Kymopsis/radar-desk-buddy/enclosure/top-shell.stl

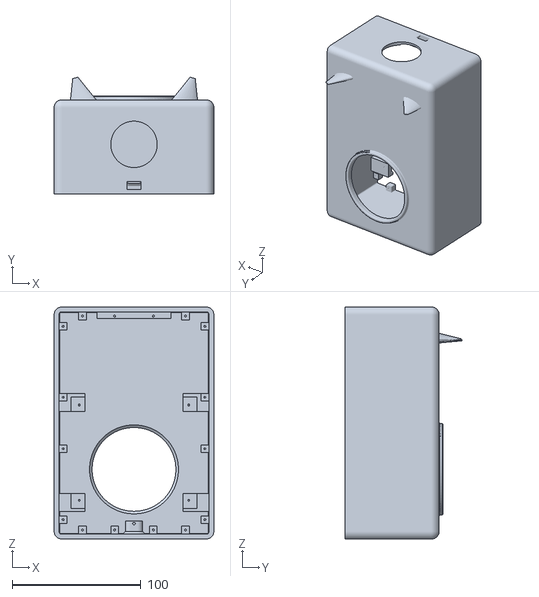
[picture p2: CAD file, 2026-10-29]
enclosure/top-shell.stl
124.0 x 90.6 x 180.0
