Kymopsis/radar-desk-buddy/enclosure/drive-link.stl

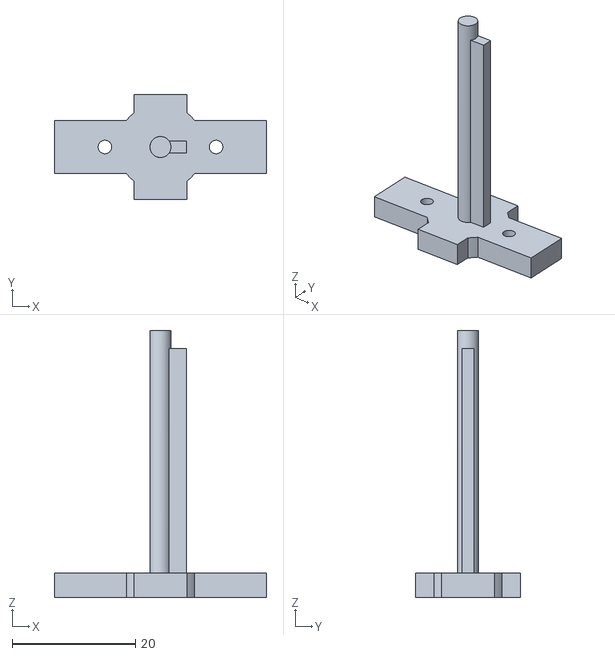
[picture p3: CAD file, 2026-10-29]
enclosure/drive-link.stl
34.4 x 17.0 x 43.2
