Kymopsis/radar-desk-buddy/enclosure/lift-base.stl

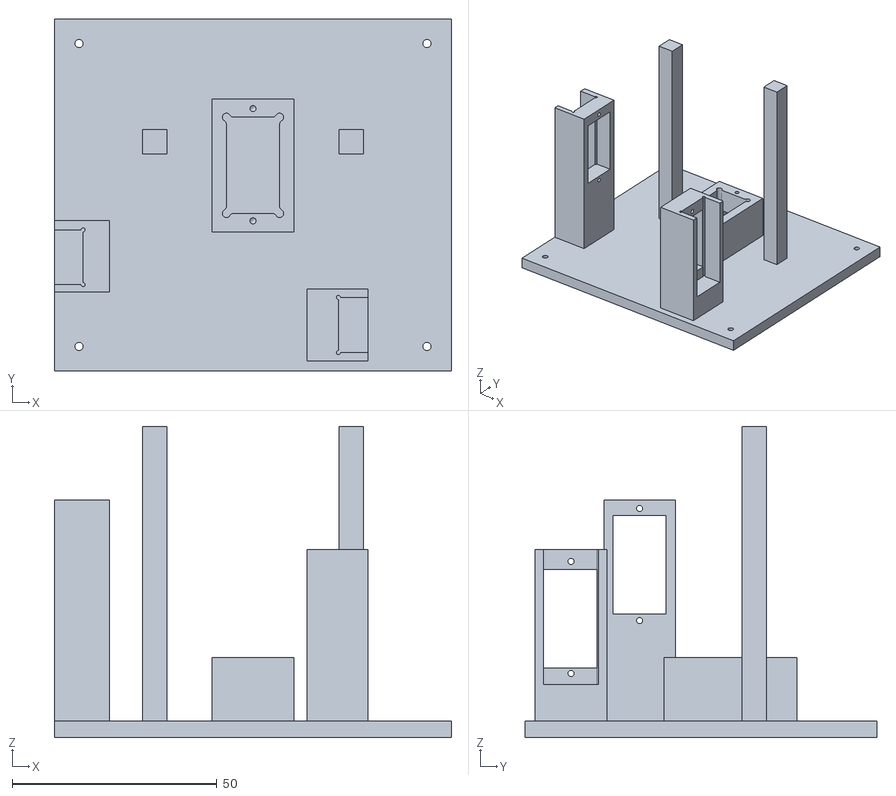
[picture p4: CAD file, 2026-10-29]
enclosure/lift-base.stl
97.0 x 86.0 x 76.0
