Kymopsis/radar-desk-buddy/enclosure/lift-crank.stl

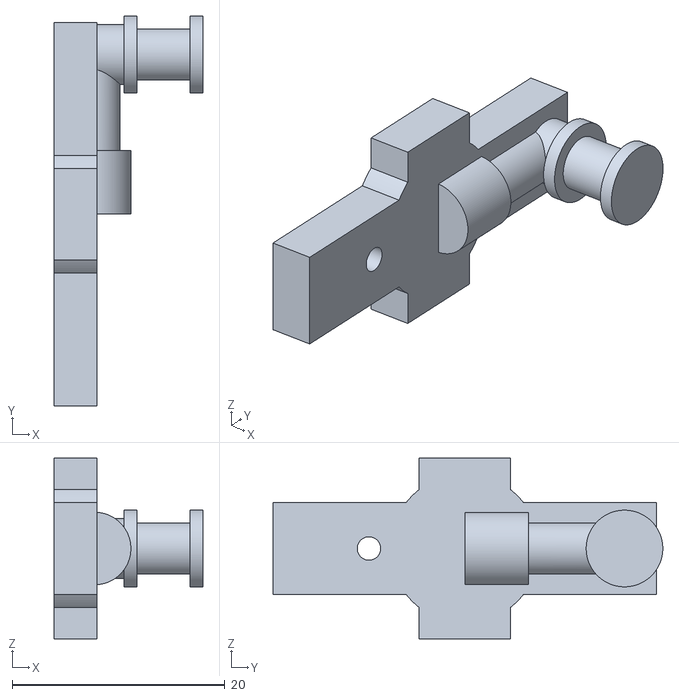
[picture p5: CAD file, 2026-10-29]
enclosure/lift-crank.stl
13.9 x 36.6 x 17.0
