Kymopsis/radar-desk-buddy/enclosure/toy-bracket.stl

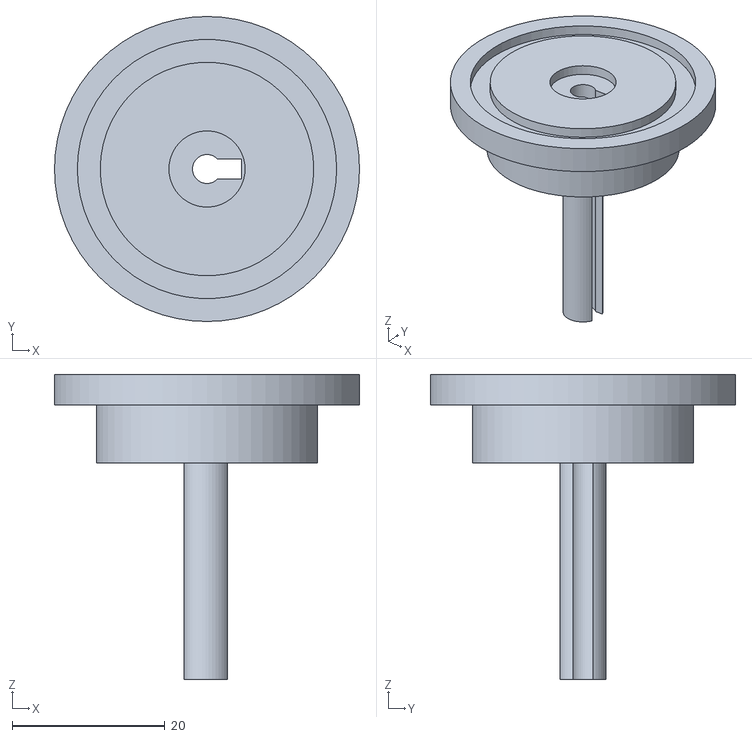
[picture p6: CAD file, 2026-10-29]
enclosure/toy-bracket.stl
40.0 x 40.0 x 40.0
