Kymopsis/radar-desk-buddy/enclosure/lift-link.stl

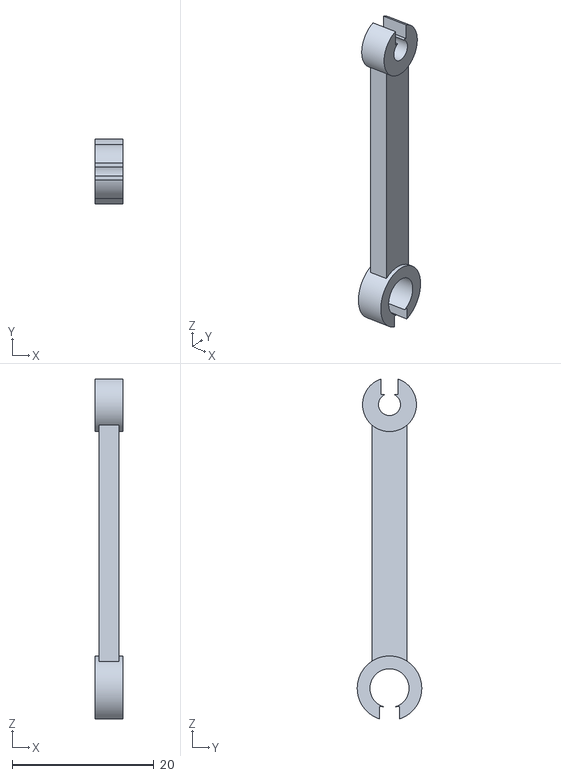
[picture p7: CAD file, 2026-10-29]
enclosure/lift-link.stl
4.00 x 9.10 x 47.9
