Kymopsis/radar-desk-buddy/enclosure/disc-bracket.stl

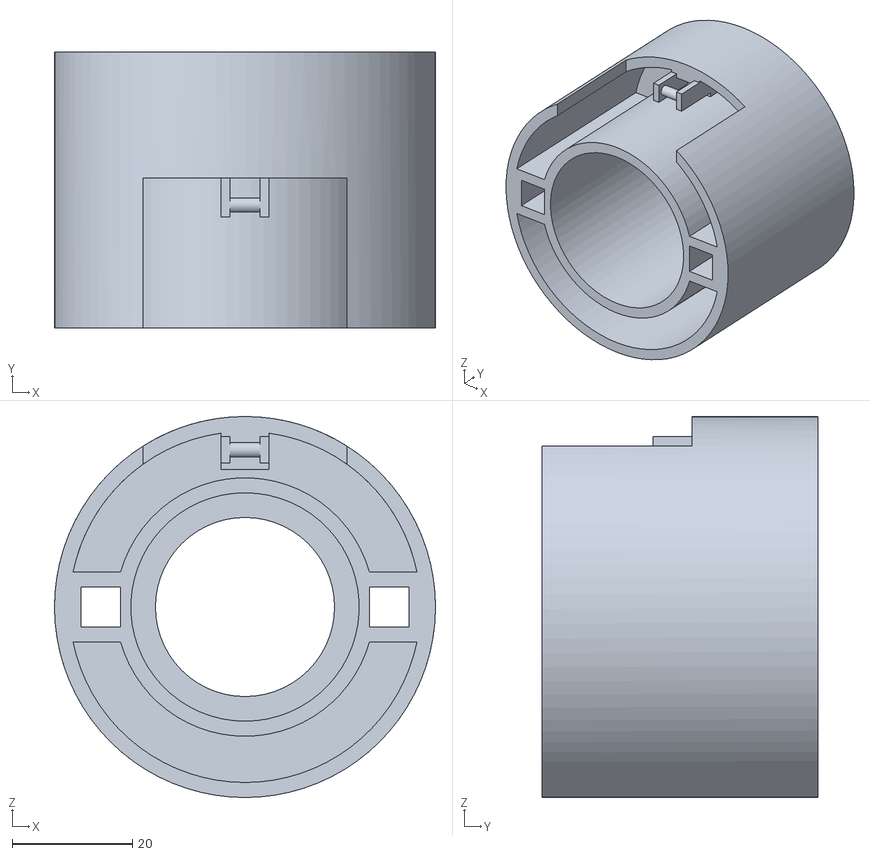
[picture p8: CAD file, 2026-10-29]
enclosure/disc-bracket.stl
63.4 x 46.0 x 63.4
