Kymopsis/radar-desk-buddy/enclosure/base-plate.stl

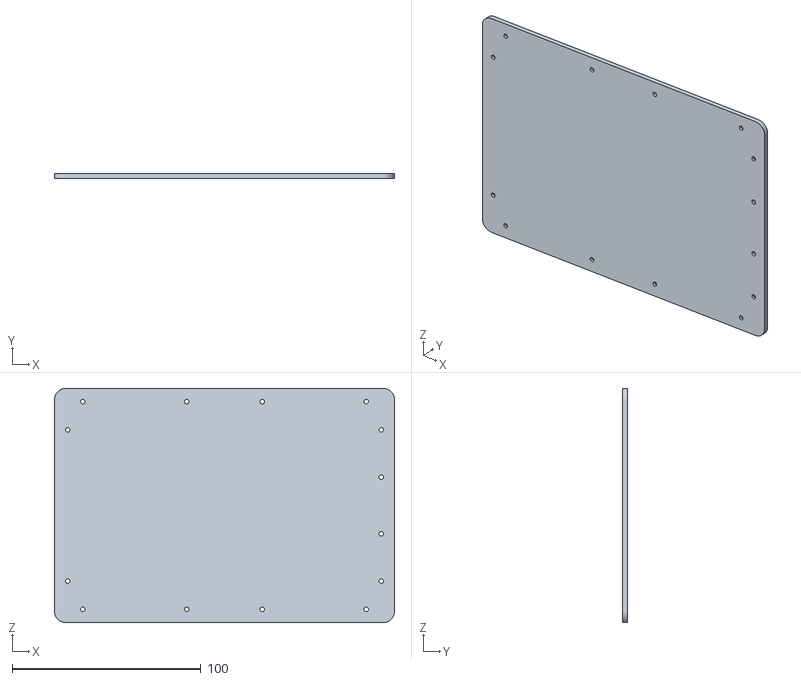
[picture p9: CAD file, 2026-10-29]
enclosure/base-plate.stl
180.0 x 2.50 x 124.0
