Kymopsis/radar-desk-buddy/(commit log)

2026-10-26 Radar Desk Buddy: initial public firmware and docs
    ESP32-S3 desk companion with a 60 GHz radar: pan/lift servos and on-screen
    eyes follow the nearest person, near field shows local time and weather,
    Telegram bot messages appear on the round screen. Levels 1 and 2 need no
    server; the optional MQTT link (Level 3) idles unless a server URL is set.
    Claude-Session: https://claude.ai/code/session_01QLf2zu8AB5F2LaDo3M65H6
    [partitions.csv]
2026-10-26 Docs: name the radar firmware to order (Presence, wall mount)
    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
2026-10-26 English-only code comments and on-screen strings; preselect radar firmware in buy link
    Translate the remaining Chinese comments and the Level 3 image-error
    messages to English, use English weather tokens, drop references to
    private design notes, and link the radar kit with the Presence, wall
    mount firmware preselected.
    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
    [board_pins.h, motion.c, mqtt_link.c, radar_link.h, radar_protocol.h, servo.h, softap_portal.h]
2026-10-26 UI: shorten English on-screen strings to fit the round screen
    Break message strings at word boundaries with explicit newlines and keep
    the 12-glyph hint lines ("Pat the head", "Tap to close") from being cut.
    [mqtt_link.c]
2026-10-26 UI font: include full printable ASCII
    The 16 px atlas was built only from the UI strings, so letters such as
    k, x, G, O, U, V, W were missing. The setup screen showed "Des Buddy",
    "P D", "RL" and "ffline", and Telegram text lost letters too.
2026-10-26 UI: wrap message text at spaces
    Telegram text was cut mid-word ("Pizza ton / ight?"). Break after the
    last space on the line when there is one; CJK and single long words still
    break per character.
2026-10-29 Add enclosure v3.2: all parts as STL and STEP
    Claude-Session: https://claude.ai/code/session_015FmX7Rs7EPv6BNREhxEuno
    [base-plate.step, base-plate.stl, disc-bracket.step, disc-bracket.stl, drive-link.stl, lift-base.step, lift-base.stl, lift-crank.stl]
2026-10-29 Enclosure docs: STEP covers the 5 main parts; height to ear tips
    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
2026-10-29 Enclosure: one flat folder with the 8 STL files to print
    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
    [base-plate.step, base-plate.stl, disc-bracket.step, disc-bracket.stl, drive-link.stl, lift-base.step, lift-base.stl, lift-crank.stl]
2026-11-12 Parts: either 60 GHz board, AiP sensor or PCB-antenna DIY board (#5)
    README, FAQ and wiring now list the AiP sensor and the PCB-antenna DIY board
    side by side, both ordered with the Presence, wall mount application, and
    give the pad numbers for each. Product links use the store's current
    attribute names.
    Claude-Session: https://claude.ai/code/session_019iTQwwsXPULXCY3sh3np4a
